WangZX2001/EG1311-Catapult-Launcher/2D CAD Deawing/EG1311 Ball Holder and Handle Drawing.pdf

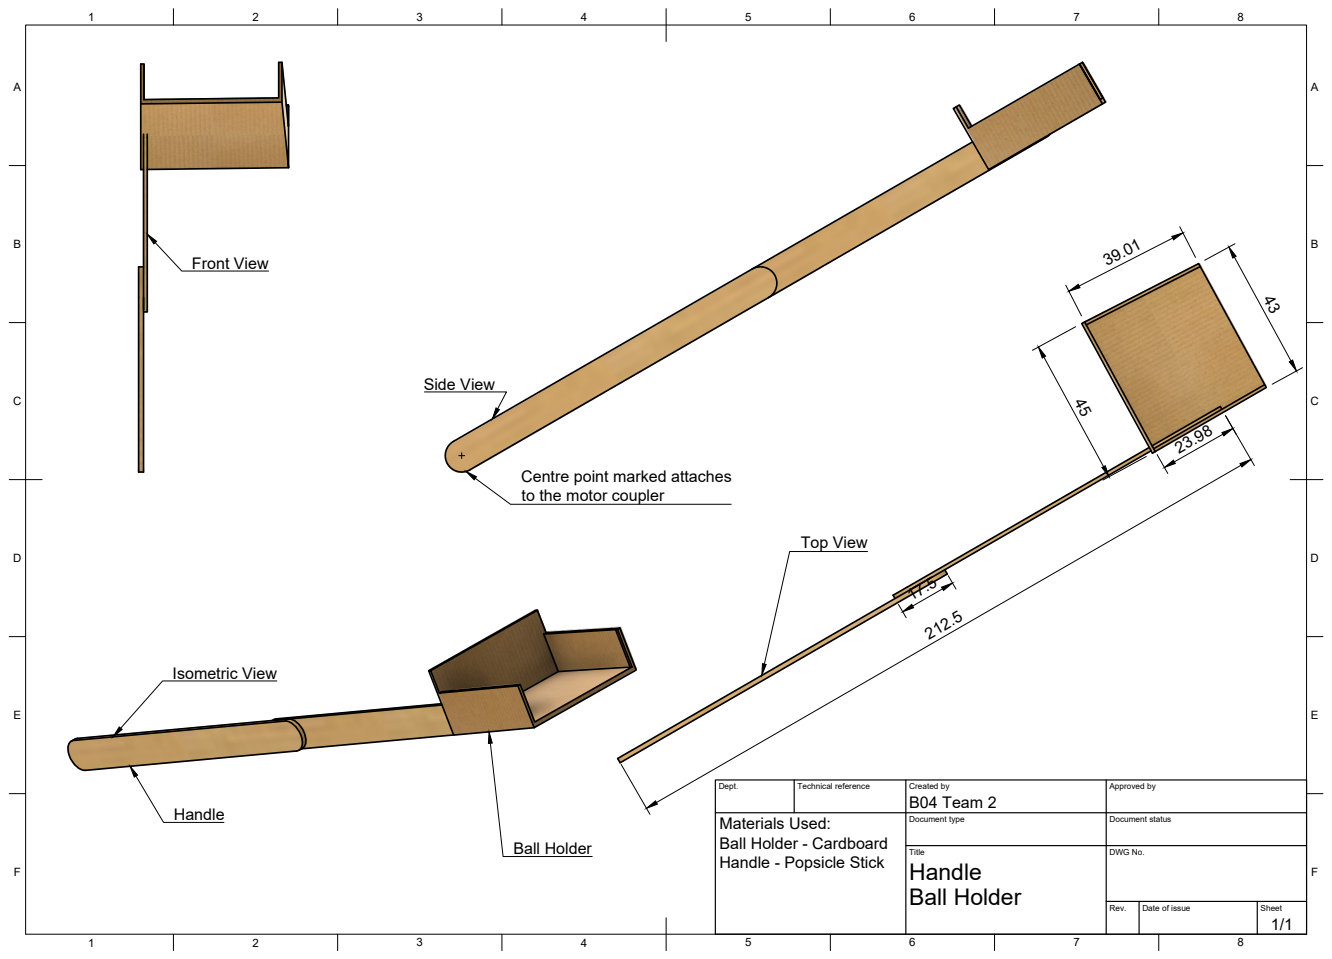
[picture p1: page 1]
Title; DWG No.; Rev.; Date of issue; Sheet; Ball Holder; Top View; Isometric View; Front View; Side View; Handle; Materials Used:

Centre point marked attaches
to the motor coupler

Dept. | Technical reference | Created by B04 Team 2 | Approved by

Document type | Document status

Ball Holder - Cardboard
Handle - Popsicle Stick
