WangZX2001/EG1311-Catapult-Launcher/2D CAD Deawing/EG1311 Base Plate and Supports Drawing.pdf

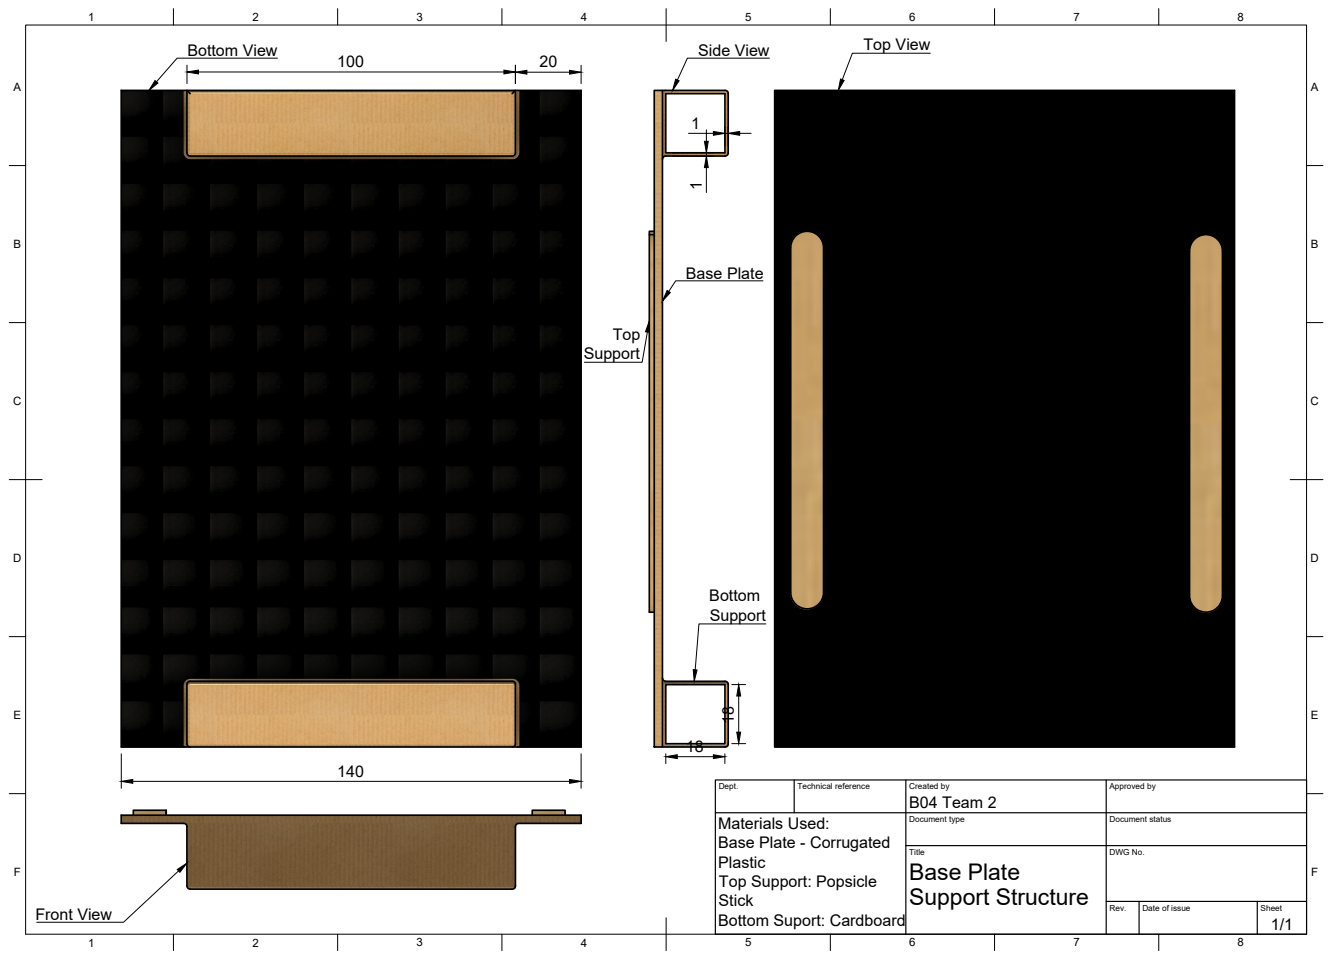
[picture p2: page 1]
Title; DWG No.; Rev.; Date of issue; Sheet; Support Structure; Base Plate; Front View; Side View 100

Top View Bottom View

Dept. | Technical reference | Created by B04 Team 2 | Approved by

Materials Used:
Base Plate - Corrugated
Plastic
Top Support: Popsicle
Stick
Bottom Suport: Cardboard

Document type | Document status
