WangZX2001/EG1311-Catapult-Launcher/2D CAD Deawing/EG1311 Holders Drawing.pdf

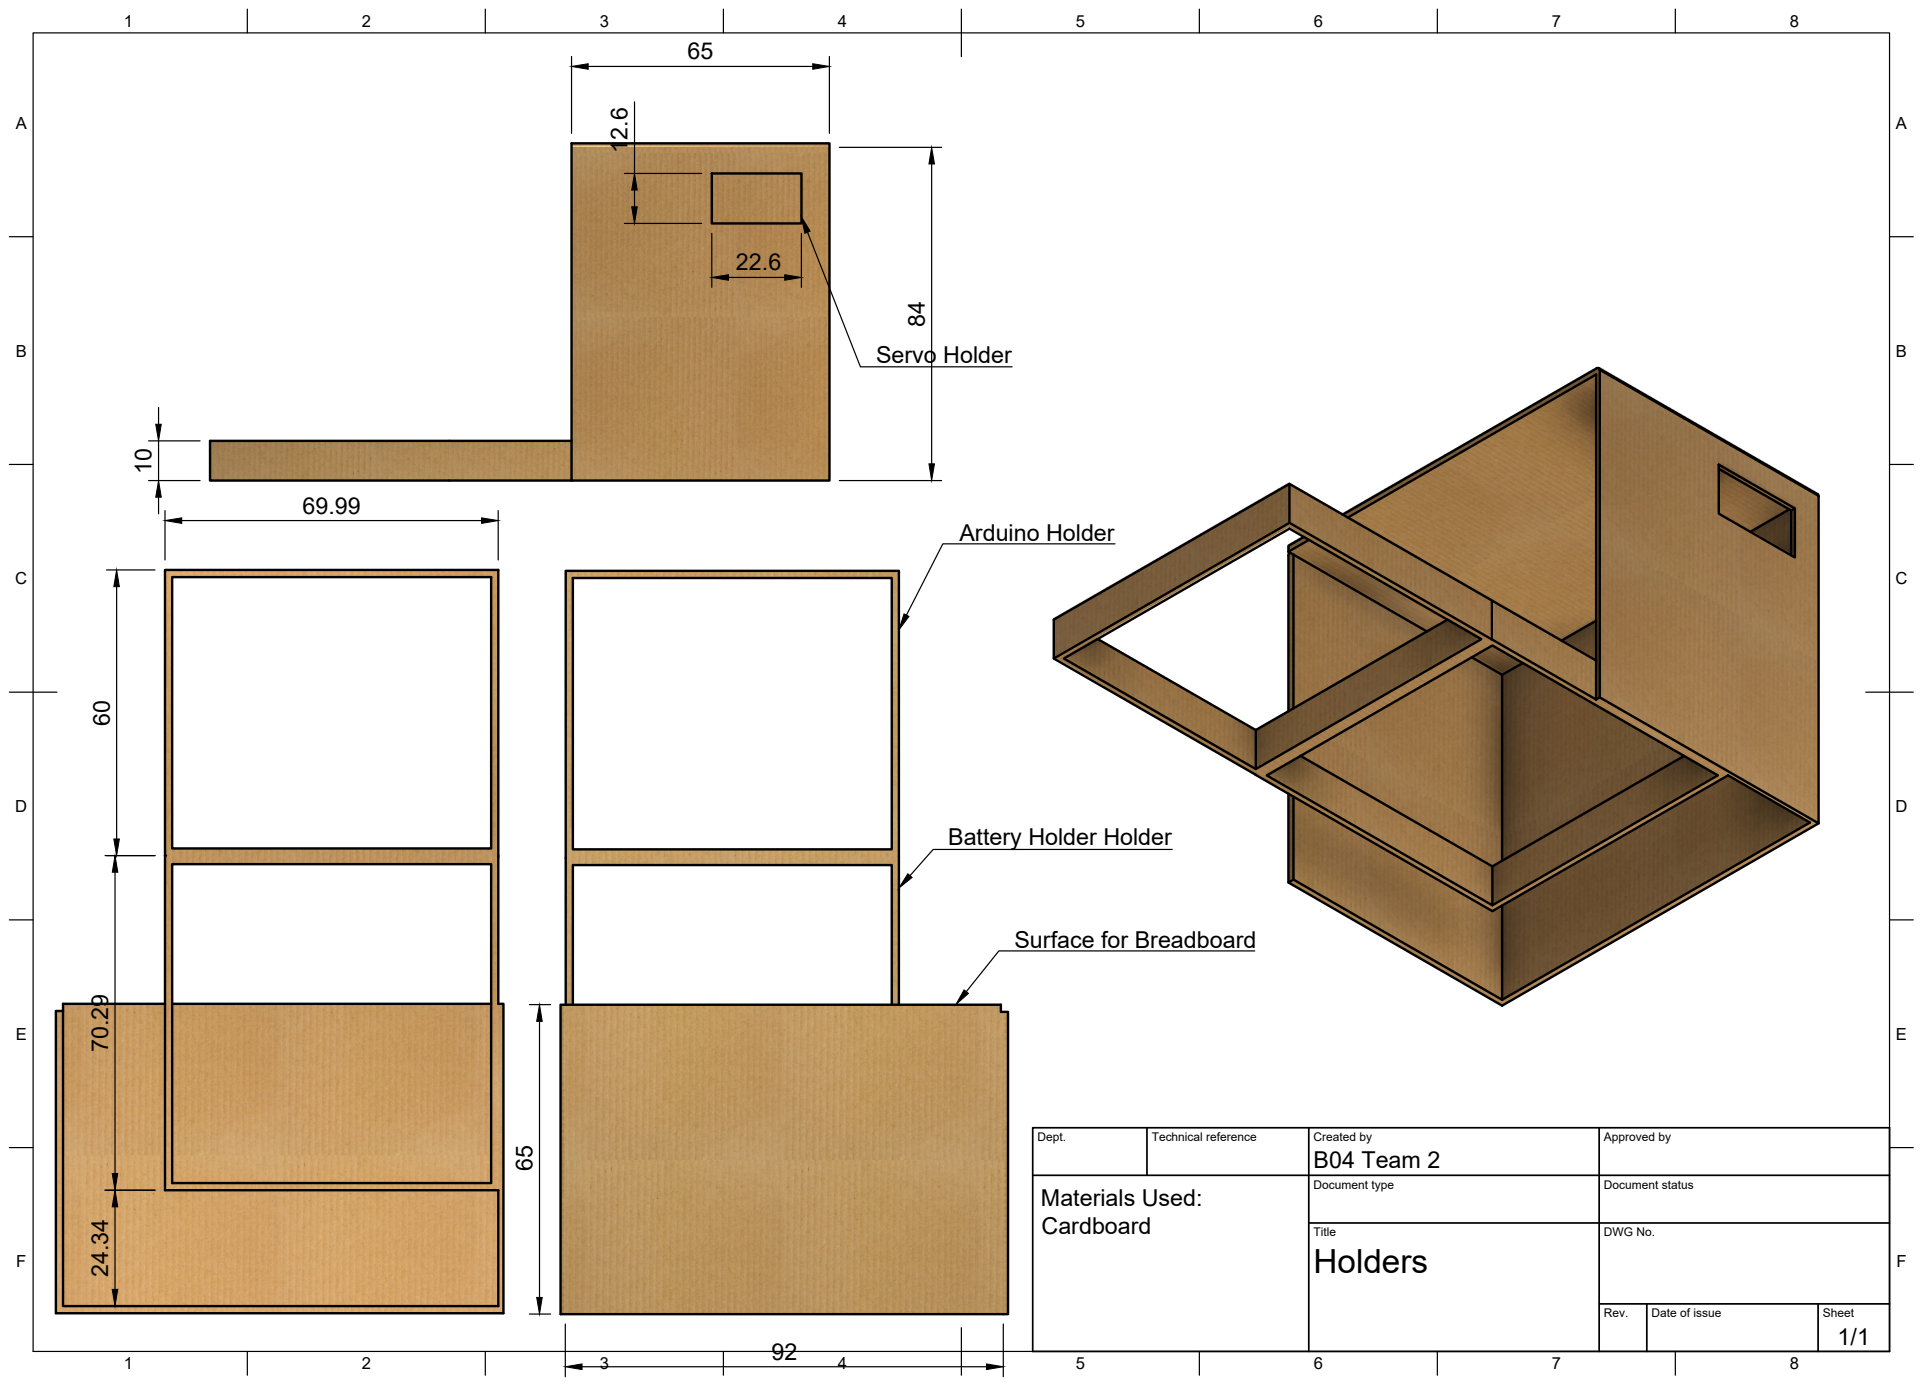
[picture p3: page 1]
Title; DWG No.; Rev.; Date of issue; Sheet; B04 Team 2 10; Arduino Holder; Servo Holder; Materials Used: Cardboard 24.34

Battery Holder Holder

Surface for Breadboard

Dept. | Technical reference | Created by | Approved by

Document type | Document status
