WangZX2001/EG1311-Catapult-Launcher/2D CAD Deawing/EG1311 Wheel Drawing.pdf

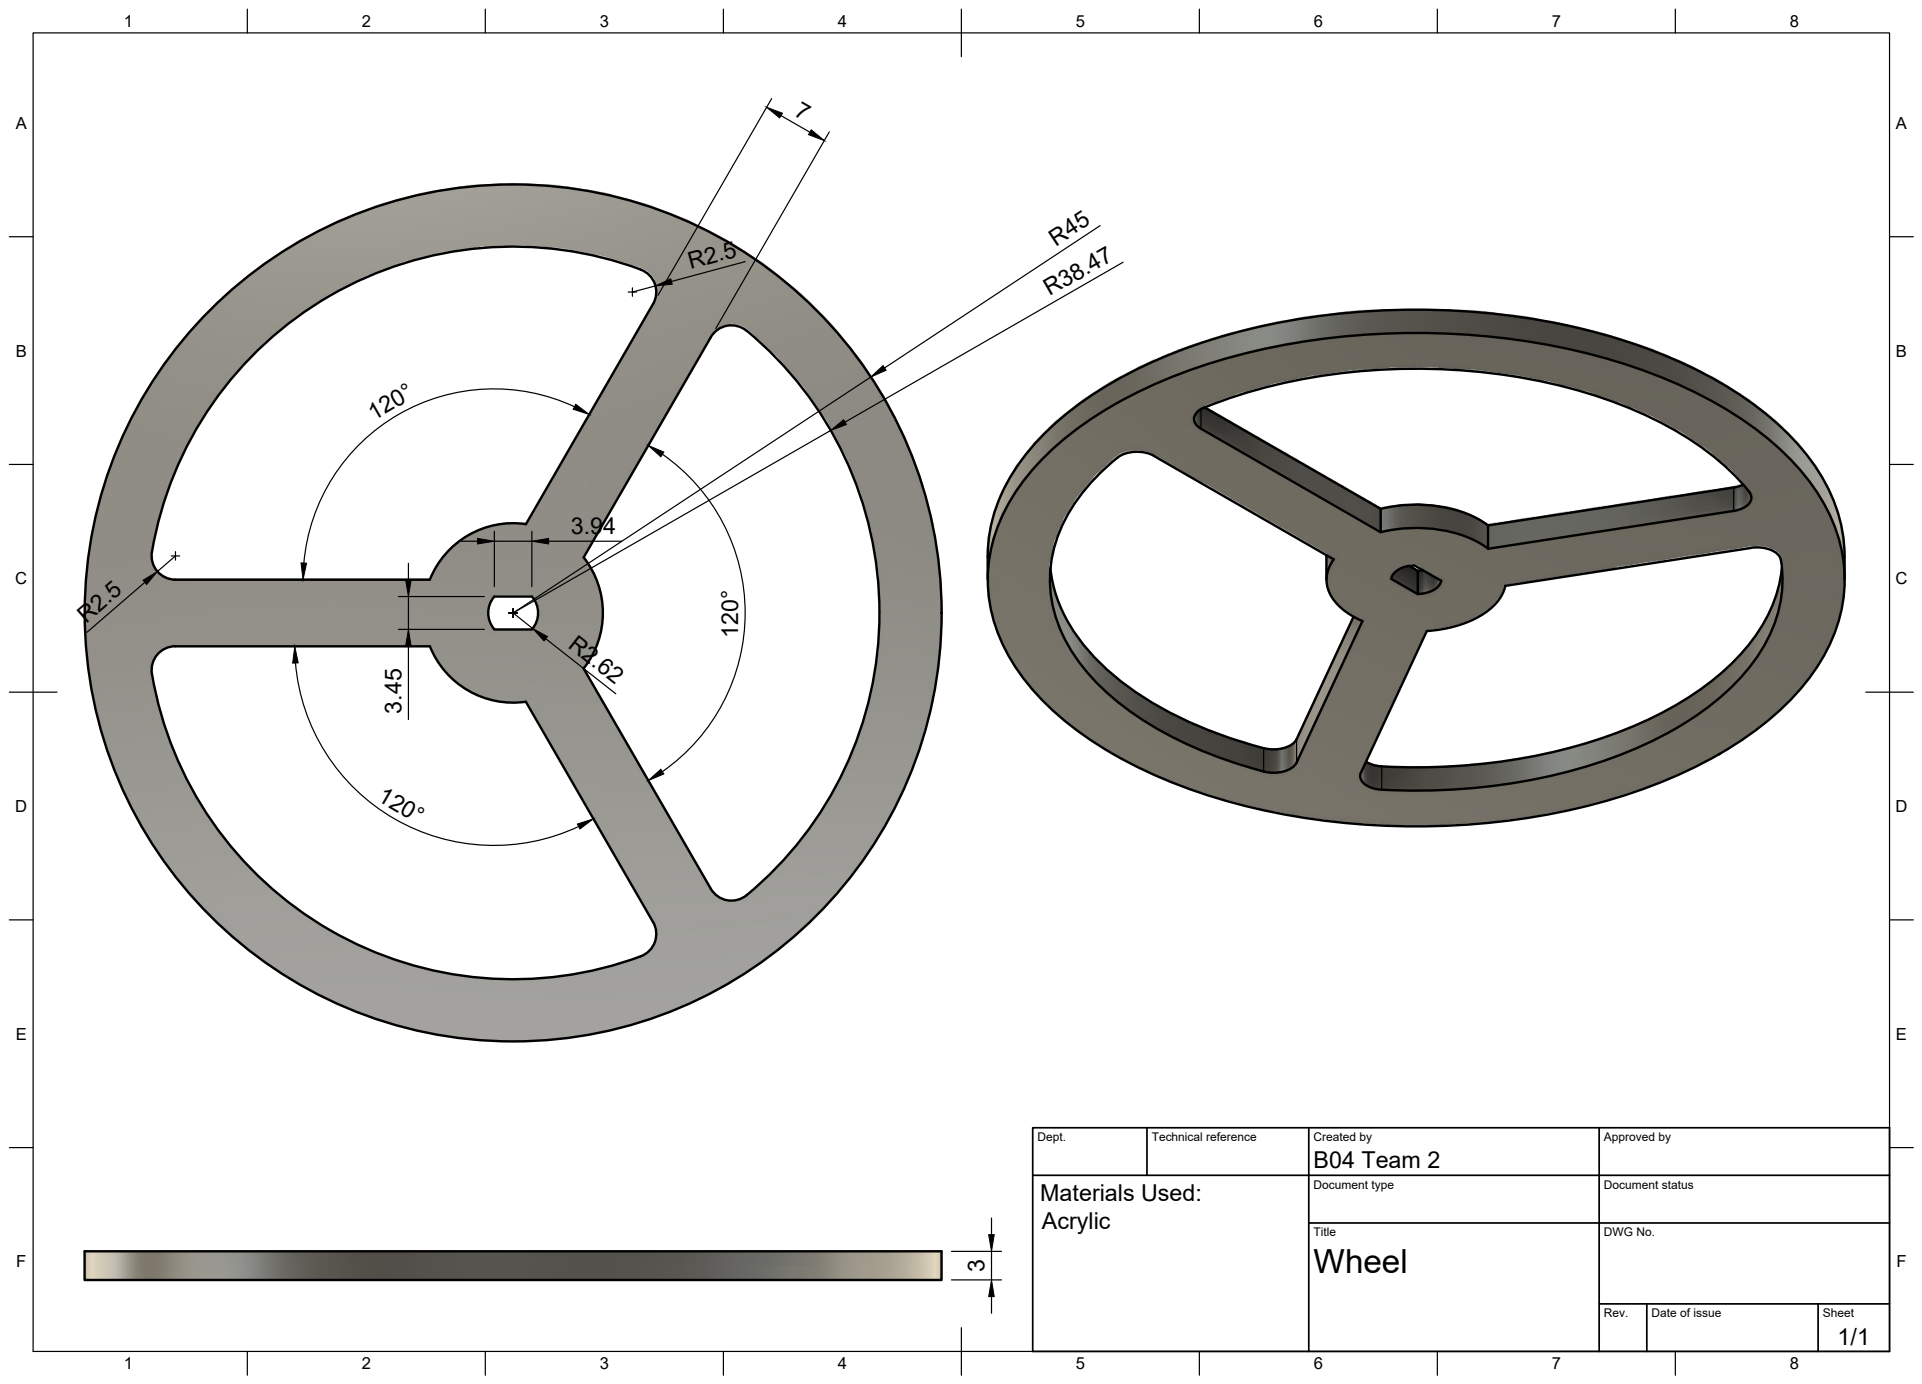
[picture p4: page 1]
Title; DWG No.; Rev.; Date of issue; Sheet; Materials Used:

Dept. | Technical reference | Created by B04 Team 2 | Approved by

Document type | Document status
