WangZX2001/EG1311-Catapult-Launcher/2D CAD Deawing/EG1311 Main Body Drawing.pdf

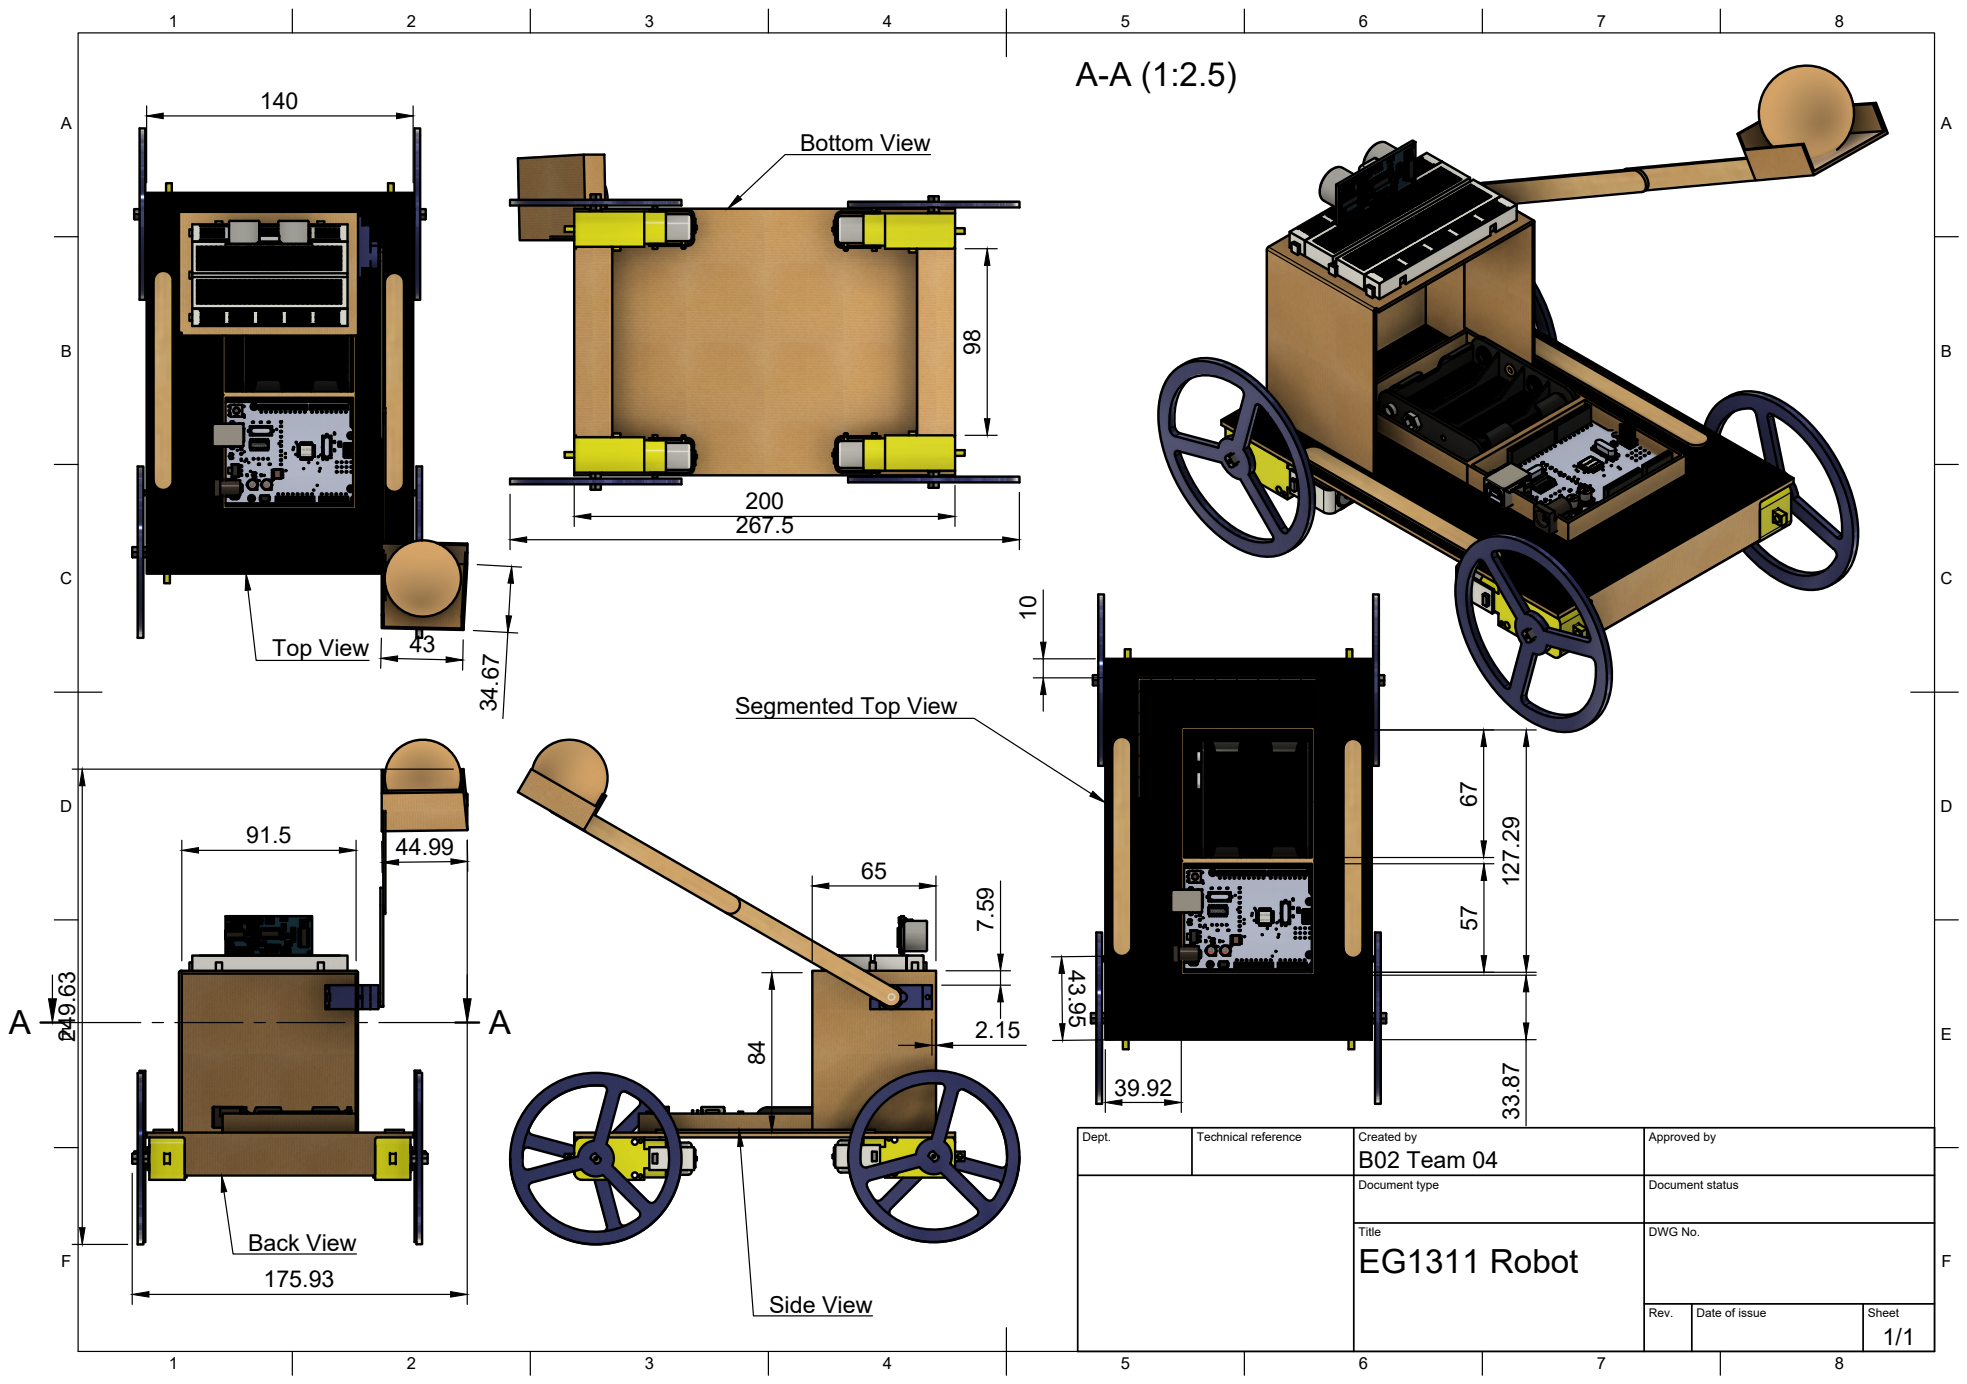
[picture p5: page 1]
Dept.; Technical reference; Created by; Approved by; Document type; Document status; Title; DWG No.; Rev.; Date of issue; Sheet; EG1311 Robot; B02 Team 04; Top View; Back View; Bottom View; Side View

Segmented Top View
